Wellesley-Solar/Electrical/README.md

# Electrical
Electrical work for the lab

## Lighting
A board with a 450nm LED for testing perovskite samples. More details [here](https://github.com/Wellesley-Solar/Electrical/blob/master/Lighting/README.md).
