Wellesley-Solar/Electrical/Lighting/Calculations/led_currentvsvoltage.jpg

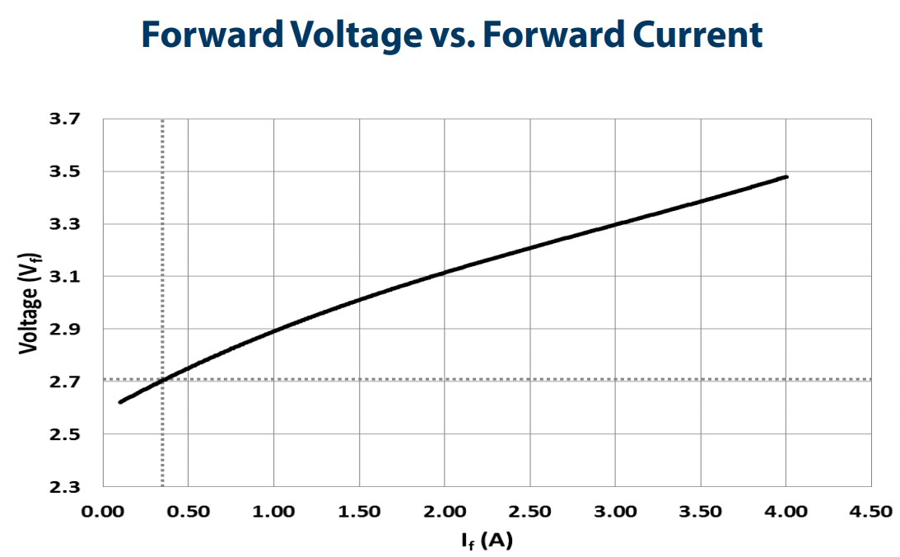
Lighting/Calculations/led_currentvsvoltage.jpg
