Wellesley-Solar/Electrical/Lighting/Calculations/led_FluxvsI.jpg

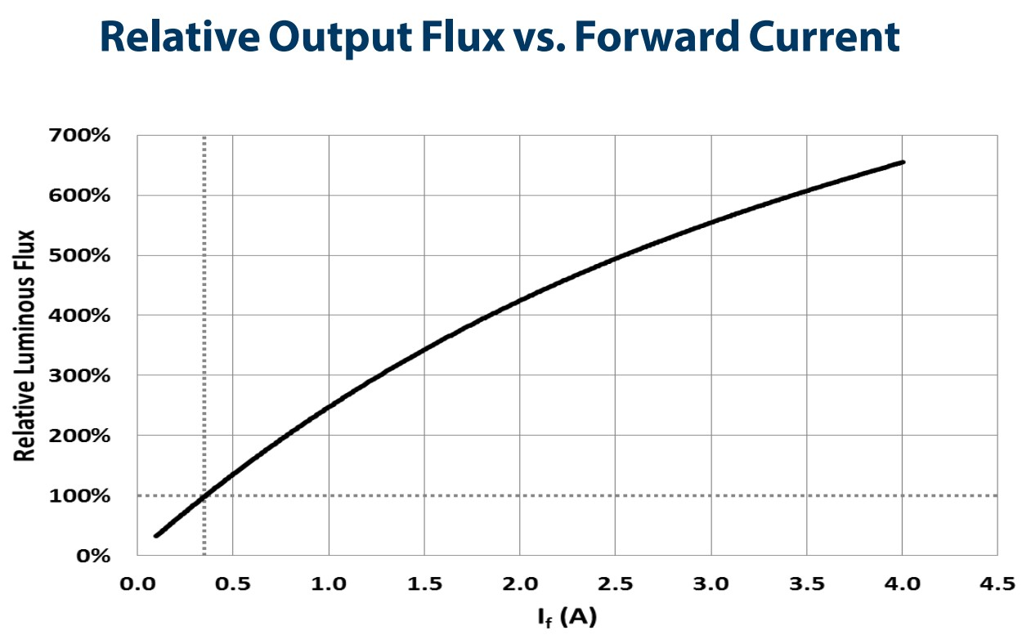
Lighting/Calculations/led_FluxvsI.jpg
