Wellesley-Solar/Electrical/Lighting/Calculations/led_spread.jpg

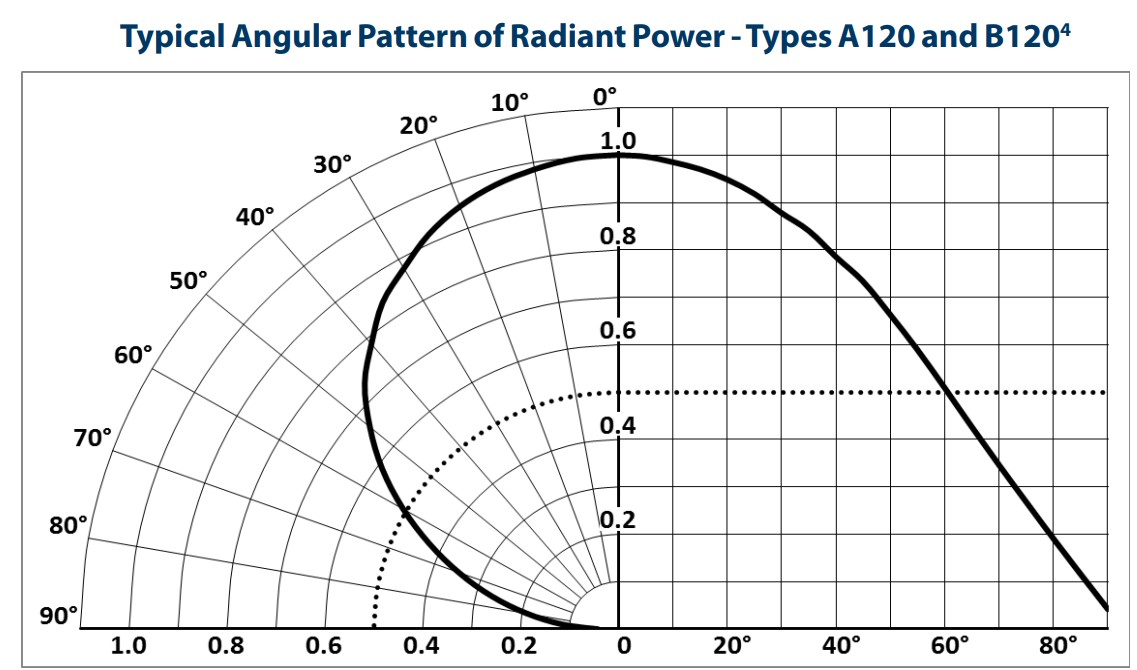
Lighting/Calculations/led_spread.jpg
