Wellesley-Solar/Electrical/Lighting/board_cut.SLDPRT

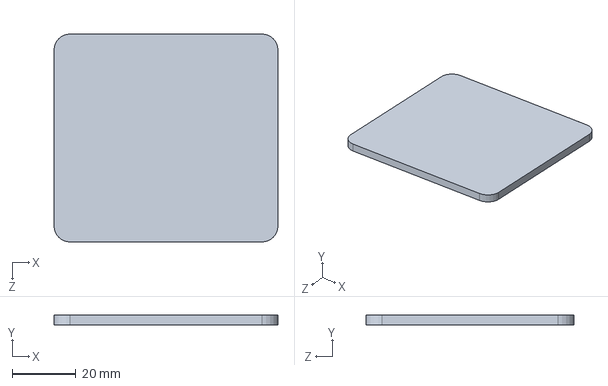
[picture p4: CAD file, 2020-04-23]
Lighting/board_cut.SLDPRT
70.0 x 3.00 x 65.0 mm
