Wellesley-Solar/Electrical/(list of files, cad)

Other CAD files:
Lighting/board_cut.DXF
