Wellesley-Solar/Electrical/Lighting/Lighting.pdf

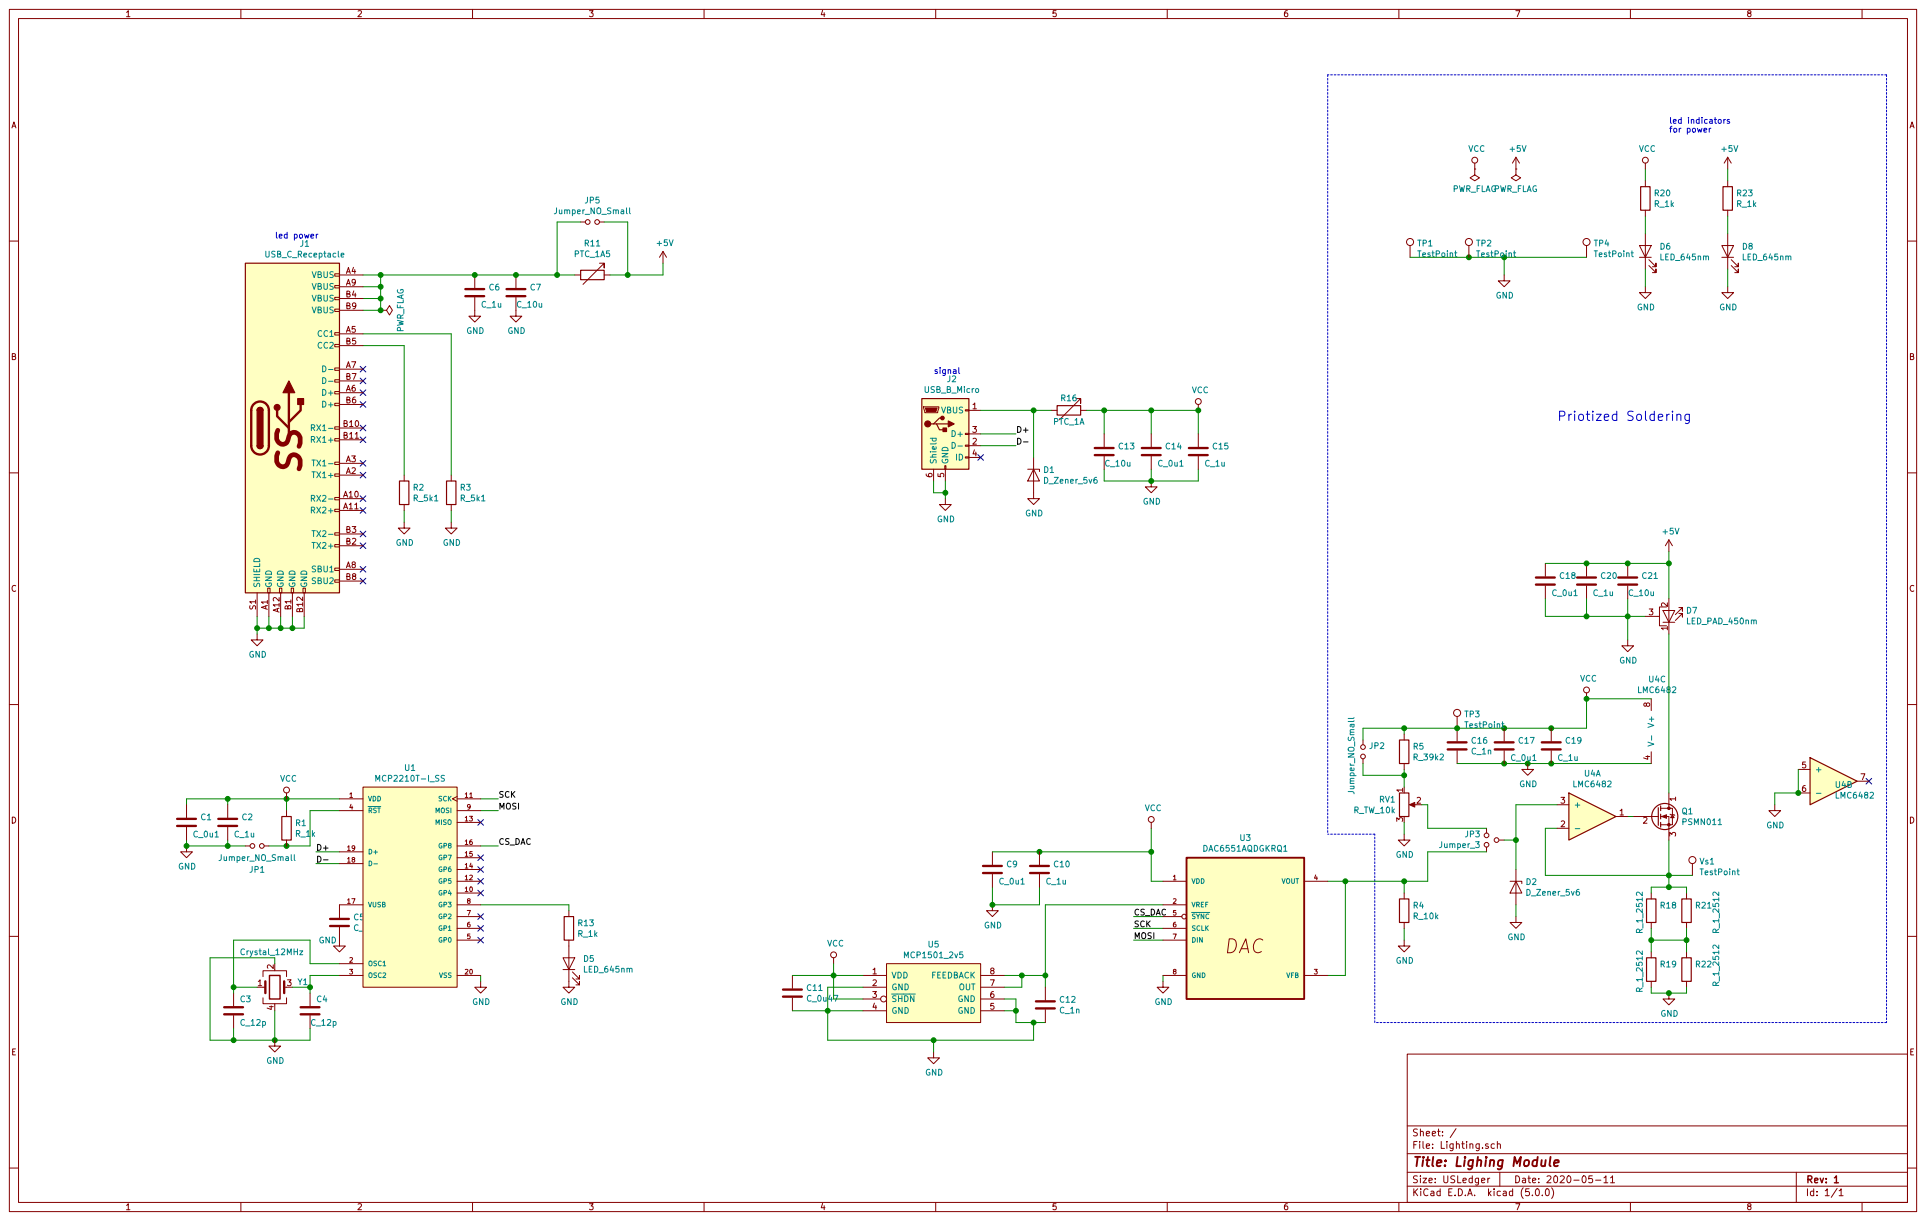
[picture p5: page 1]

Id: 1/1 Title: Lighing Module
