Wellesley-Solar/Electrical/Lighting/Lighting.kicad_pcb

## KiCad design Lighting/Lighting.kicad_pcb (2020-08-04)

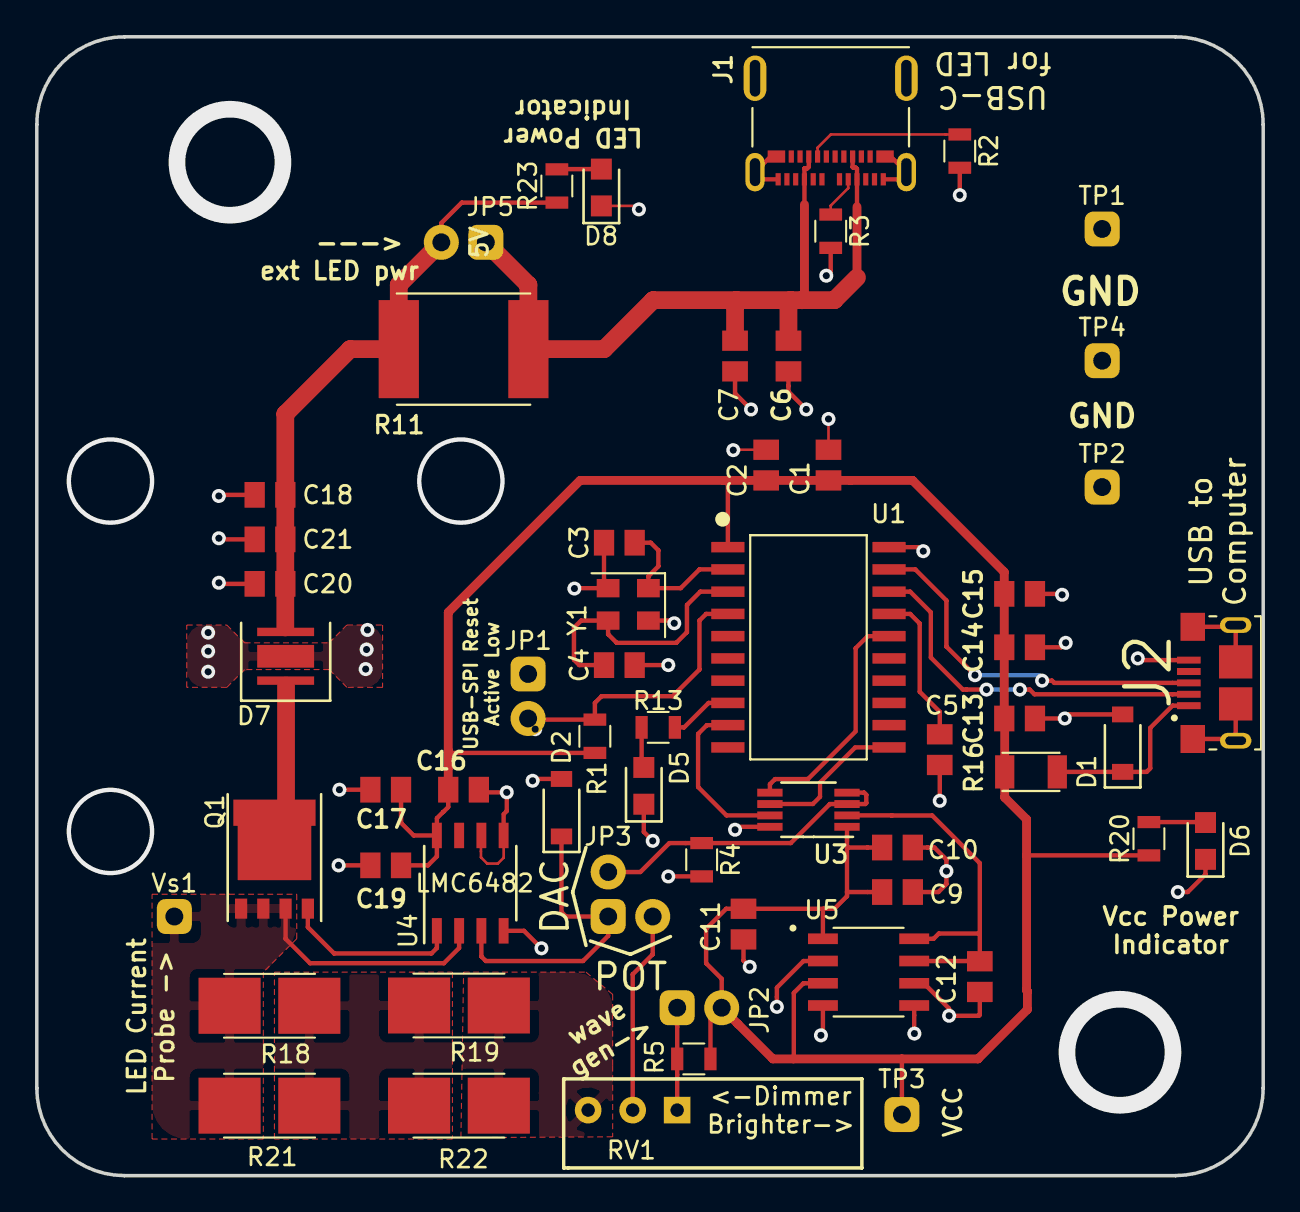
[picture p6: board Lighting.kicad_pcb from above]

Board: 2 copper layers, 70.0 x 65.0 mm, 58 parts (0 on the bottom side), 29 nets.

Parts:
C1, C9, C14, C17, C18: C_0u1; C_0805
C2, C6, C10, C15, C19, C20: C_1u; C_0805
C3, C4: C_12p; C_0805
C5, C11: C_0u47; C_0805
C7, C13, C21: C_10u; C_0805
C12, C16: C_1n; C_0805
D1, D2: D_Zener_5v6; SOD123
D5, D6, D8: LED_645nm; LED0805
D7: LED_PAD_450nm; SST-20-A120
J1: USB_C_Receptacle; MOLEX_105450-0101
J2: USB_B_Micro; FCI_10118193-0001LF
JP1, JP2, JP5: Jumper_NO_Small; jumper_2
JP3: Jumper_3; jumper_3
Q1: PSMN011; Power_SO8
R1, R13, R20, R23: R_1k; R0805
R2, R3: R_5k1; R0805
R4: R_10k; R0805
R5: R_39k2; R0805
R11: PTC_1A5; RESC2920
R16: PTC_1A; RESC3216X125N
R18, R19, R21, R22: R_1_2512; R_2512_2W
RV1: R_TW_10k; POT_3352W
TP1, TP2, TP3, TP4: TestPoint; TP
U1: MCP2210T-I_SO; SOIC127P1030X265-20N
U3: DAC6551AQDGKRQ1; SOP65P490X110-9N
U4: LMC6482; LMC6482AIMX&slash_NOPB
U5: MCP1501_2v5; SOIC127P600X175-8N
Vs1: TestPoint; TP
Y1: Crystal_12MHz; Kyocera_Crystal

Connections:
+5V: C18.1, C20.1, C21.1, D7.2, JP5.2, R11.1, R23.1
/CS_DAC: U1.16, U3.5
/D+: J2.3, U1.19
/D-: J2.2, U1.18
/MOSI: U1.9, U3.7
/SCK: U1.11, U3.6
GND: C1.2, C2.2, C3.2, C4.2, C5.2, C6.2, C7.2, C9.2, C10.2, C11.2, C12.2, C13.2, C14.2, C15.2, C16.2, C17.2, C18.2, C19.2, C20.2, C21.2, D1.2, D2.2, D5.1, D6.1, D7.3, D8.1, J1.A1, J1.A12, J1.B1, J1.B12, J1.S1, J2.5, J2.6, JP1.1, R2.2, R3.2, R4.2, R19.2, R22.2, RV1.3, TP1.1, TP2.1, TP4.1, U1.20, U3.8, U4.4, U4.5, U4.6, U5.2, U5.4, U5.5, U5.6, Y1.2, Y1.4
unnamed: C3.1, U1.2, Y1.1
unnamed: C4.1, U1.3, Y1.3
unnamed: C5.1, U1.17
unnamed: C6.1, C7.1, J1.A4, J1.A9, J1.B4, J1.B9, JP5.1, R11.2
unnamed: C12.1, U3.2, U5.7, U5.8
unnamed: D1.1, J2.1, R16.2
unnamed: D2.1, JP3.1, U4.3
unnamed: D5.2, R13.2
unnamed: D6.2, R20.2
unnamed: D7.1, Q1.1
unnamed: D8.2, R23.2
unnamed: J1.A5, R3.1
unnamed: J1.B5, R2.1
unnamed: JP1.2, R1.2, U1.4
unnamed: JP2.1, R5.2, RV1.1
unnamed: JP3.2, R4.1, U3.3, U3.4
unnamed: JP3.3, RV1.2
unnamed: Q1.2, U4.1
unnamed: Q1.3, R18.1, R21.1, U4.2, Vs1.1
unnamed: R13.1, U1.8
unnamed: R18.2, R19.1, R21.2, R22.1
VCC: C1.1, C2.1, C9.1, C10.1, C11.1, C13.1, C14.1, C15.1, C16.1, C17.1, C19.1, JP2.2, R1.1, R5.1, R16.1, R20.1, TP3.1, U1.1, U3.1, U4.8, U5.1, U5.3
