Wellesley-Solar/Electrical/(commit log)

2020-03-26 initial starting work for light source
    [Lighting.kicad_pcb, Lighting.sch]
2020-04-02 add matlab calculations; add ADC, USB-C, FTIR componenets
    [Lighting.sch]
2020-04-08 finished schematic for all but USB-C for portable power
    [Lighting.sch]
2020-04-10 finished schematic with PDF
    [Lighting.sch]
2020-04-13 add external voltage reference
    [Lighting.sch]
2020-04-13 correct pot footprint
    [Lighting.sch]
2020-04-23 finish PCB layout and output gerber
    [Lighting-B.Cu.gbr, Lighting-B.Mask.gbr, Lighting-B.SilkS.gbr, Lighting-Edge.Cuts.gbr, Lighting-F.Cu.gbr, Lighting-F.Mask.gbr, Lighting-F.SilkS.gbr, Lighting.drl]
2020-04-23 add latest bom
    [Lighting.csv]
2020-04-23 try to make it look okay
    [Lighting.csv]
2020-04-23 look nice
    [Lighting.csv]
2020-04-23 update gerber
    [Lighting-B.Cu.gbr, Lighting-B.Mask.gbr, Lighting-B.SilkS.gbr, Lighting-Edge.Cuts.gbr, Lighting-F.Cu.gbr, Lighting-F.Mask.gbr, Lighting-F.SilkS.gbr, Lighting.drl]
2020-04-23 gerber zip looks good to me
    [Lighting-B.Cu.gbr, Lighting-B.Mask.gbr, Lighting-B.SilkS.gbr, Lighting-Edge.Cuts.gbr, Lighting-F.Cu.gbr, Lighting-F.Mask.gbr, Lighting-F.SilkS.gbr, Lighting.drl]
2020-05-12 changes based on feedback
    [Lighting.csv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]
2020-05-12 fix netlist
    [Lighting.csv]
2020-05-12 latest gerber
    [Lighting-B.Cu.gbr, Lighting-B.Mask.gbr, Lighting-B.SilkS.gbr, Lighting-Edge.Cuts.gbr, Lighting-F.Cu.gbr, Lighting-F.Mask.gbr, Lighting-F.SilkS.gbr, Lighting.drl]
2020-08-04 minor trace fix; add readme
    [Lighting-B.Cu.gbr, Lighting-B.Mask.gbr, Lighting-B.SilkS.gbr, Lighting-Edge.Cuts.gbr, Lighting-F.Cu.gbr, Lighting-F.Mask.gbr, Lighting-F.SilkS.gbr, Lighting.drl]
2020-08-04 add csv file for calculations
    [led_FluxvsI.csv, led_IvsV.csv, led_spread.csv]
2020-08-23 fix 1u cap link mistake; give mcp2210 correct name
    [Lighting.csv, Lighting.sch]
2020-08-23 update schematic pdf
2020-08-23 fix 39k2 resistor error
    [Lighting.csv, Lighting.sch]
2021-05-18 lighting protoboard
    [Lighting-B.Cu.gbr, Lighting-B.Mask.gbr, Lighting-B.SilkS.gbr, Lighting-Edge.Cuts.gbr, Lighting-F.Cu.gbr, Lighting-F.Mask.gbr, Lighting-F.SilkS.gbr, Lighting.drl]
